FmasterofU/bachelor-thesis/thesis/fritzing model/exports/sketch_bb.png

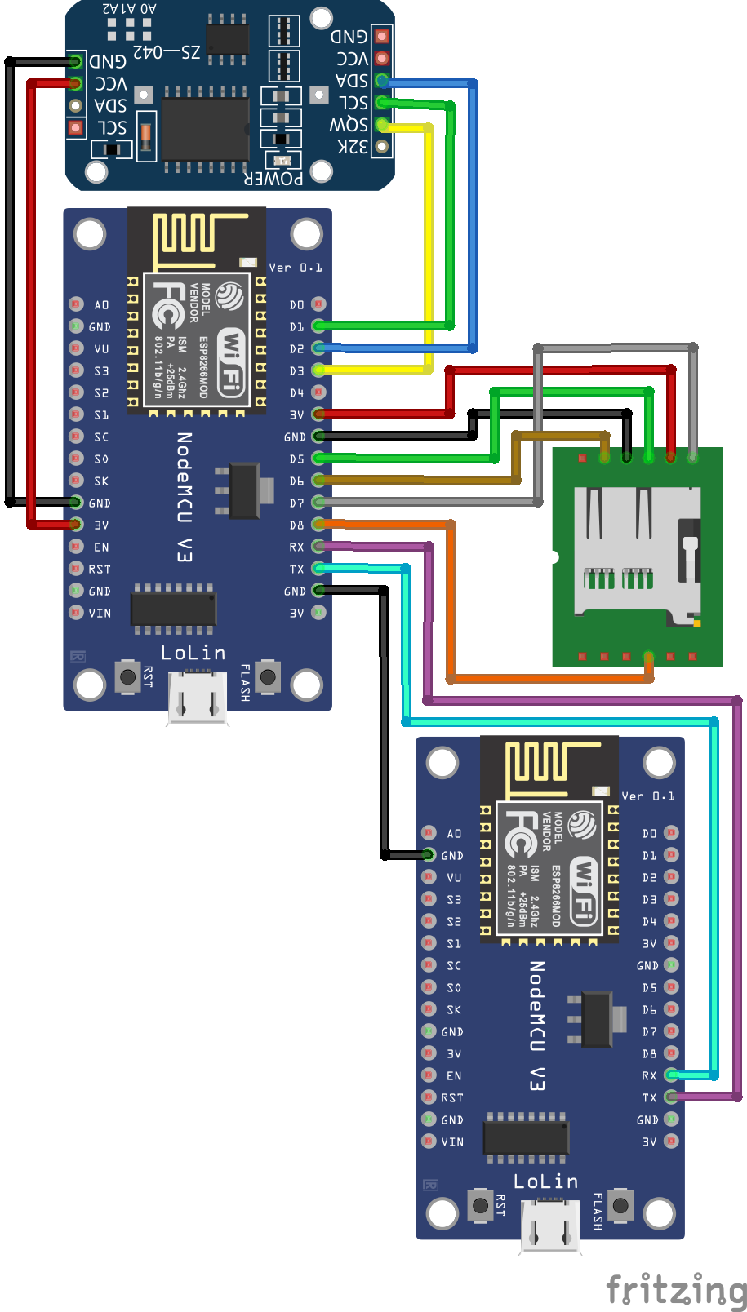
thesis/fritzing model/exports/sketch_bb.png
