FmasterofU/bachelor-thesis/thesis/fritzing model/exports/sketch_schem.png

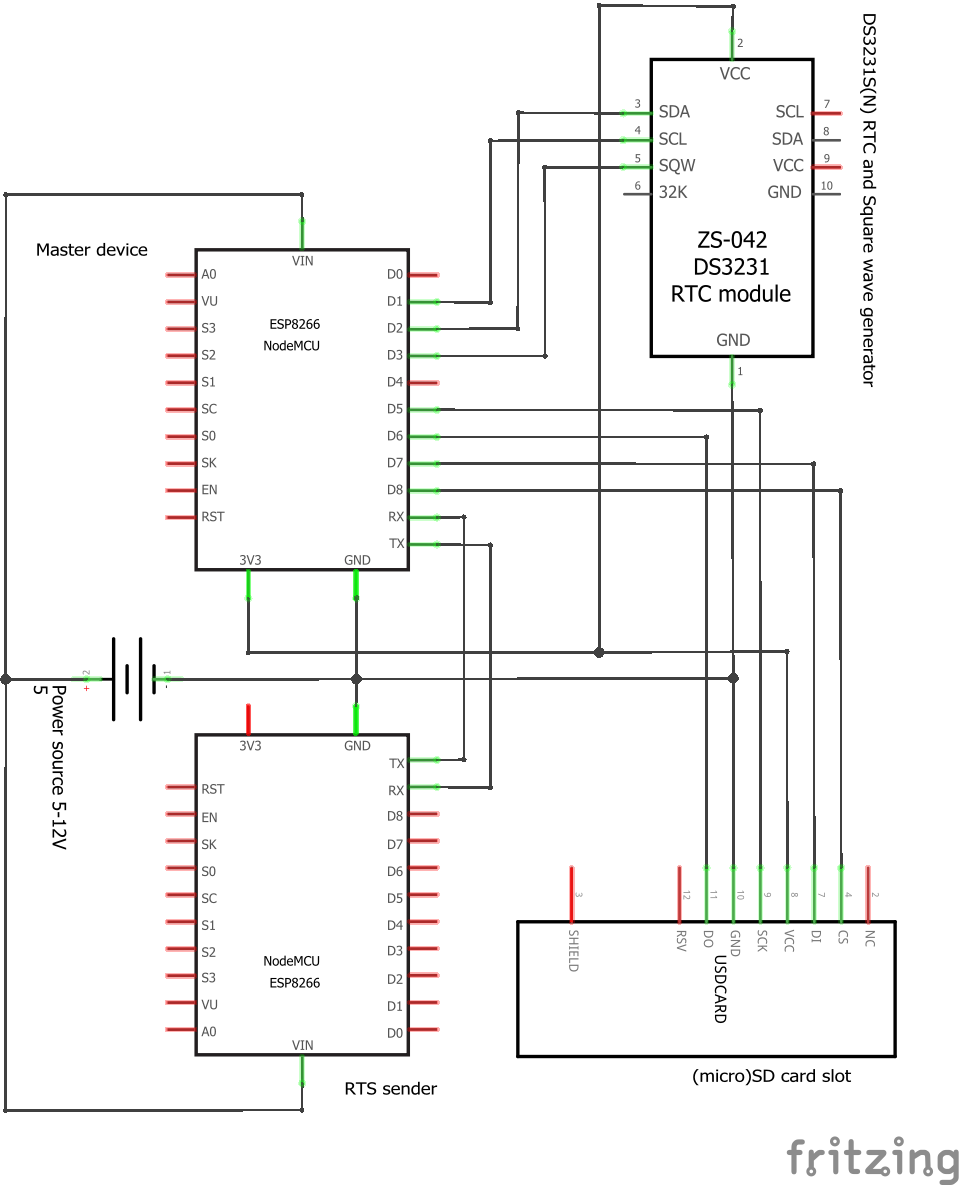
thesis/fritzing model/exports/sketch_schem.png
