FmasterofU/bachelor-thesis/(list of files, drawings)

Other design files:
thesis/fritzing model/sketch.fzz
