FmasterofU/bachelor-thesis/(commit log)

2021-09-18 model, sketch
    [sketch.fzz]
2021-09-30 reorganizing repo
    [sketch.fzz]
